hatjipapask-lab/PONG-PROJECT/(list of files, drawings)

Other design files:
display_logisim_simul.circ
